dezsoba/Szakdolgozat/Szakdolgozat képek/FixBoardBodge/CIMG1764.JPG

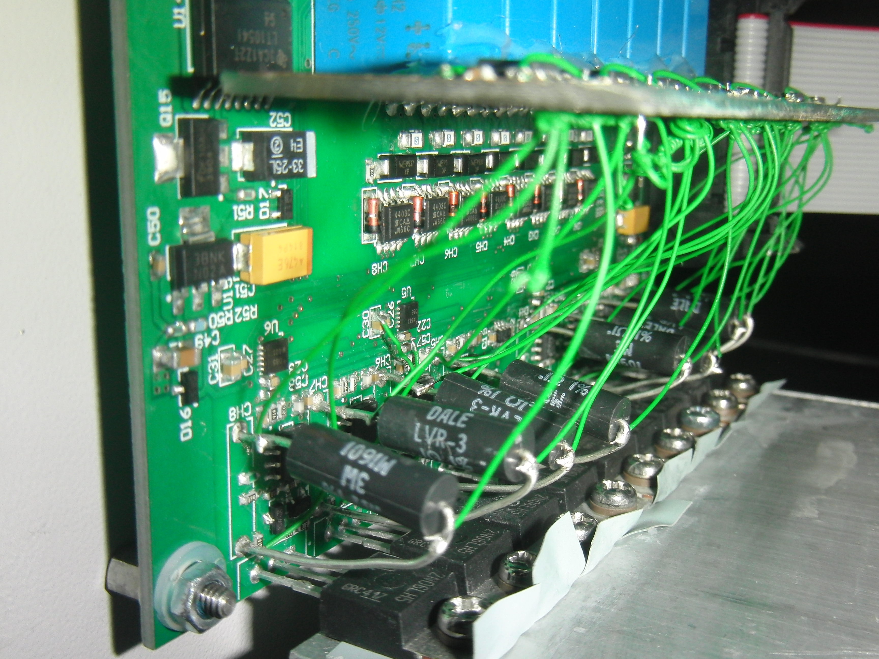
Szakdolgozat képek/FixBoardBodge/CIMG1764.JPG
