dezsoba/Szakdolgozat/Szakdolgozat képek/FixBoardBodge/CIMG1762.JPG

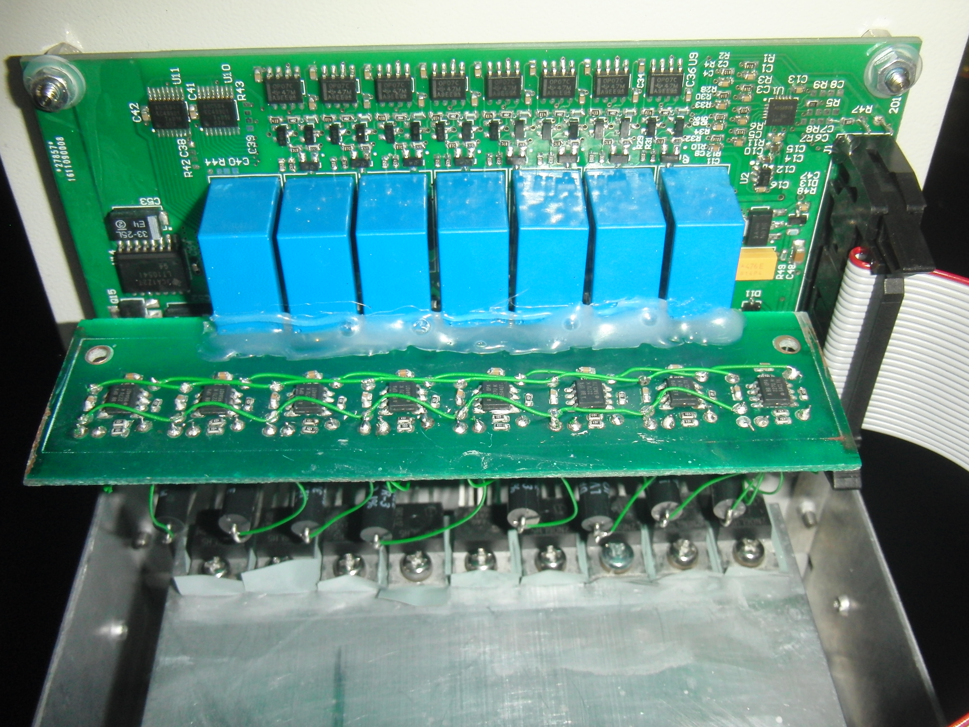
Szakdolgozat képek/FixBoardBodge/CIMG1762.JPG
