dezsoba/Szakdolgozat/Táblázatok/Spec.xlsx

Voltage | Current
15.5 | 0
15.5 | 0.645
15 | 0.666666
14 | 0.71
13 | 0.77
12 | 0.83
11 | 0.91
10 | 1
9 | 1.11
8 | 1.25
7 | 1.43
6 | 1.67
5 | 2
2.22 | 2
1.8 | 0
15.5 | 0
