dezsoba/Szakdolgozat/CopperArea_3V3.png

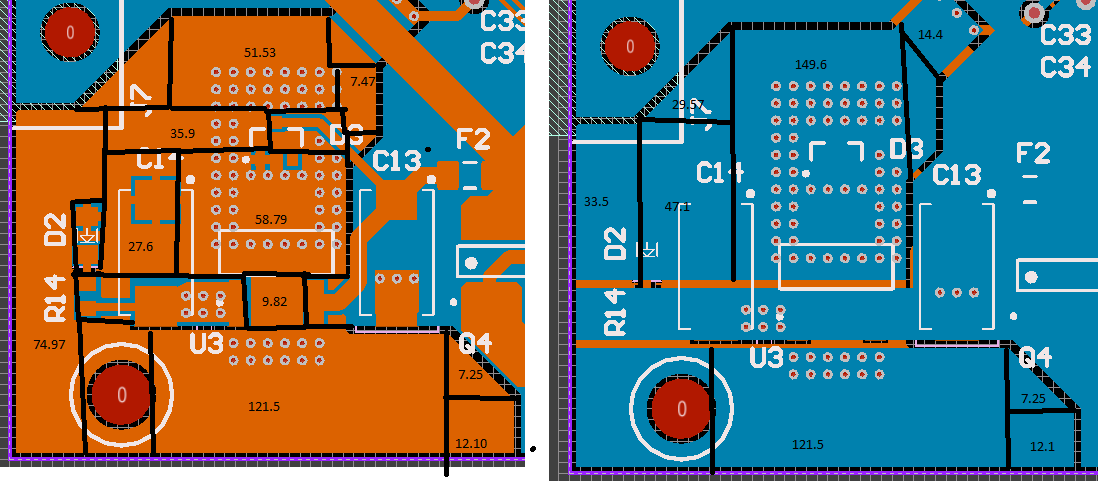
CopperArea_3V3.png
