dezsoba/Szakdolgozat/CopperArea_N7V.png

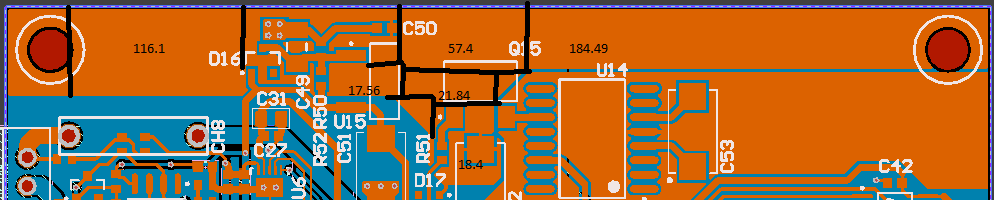
CopperArea_N7V.png
