dezsoba/Szakdolgozat/Szakdolgozat képek/2Opamp.png

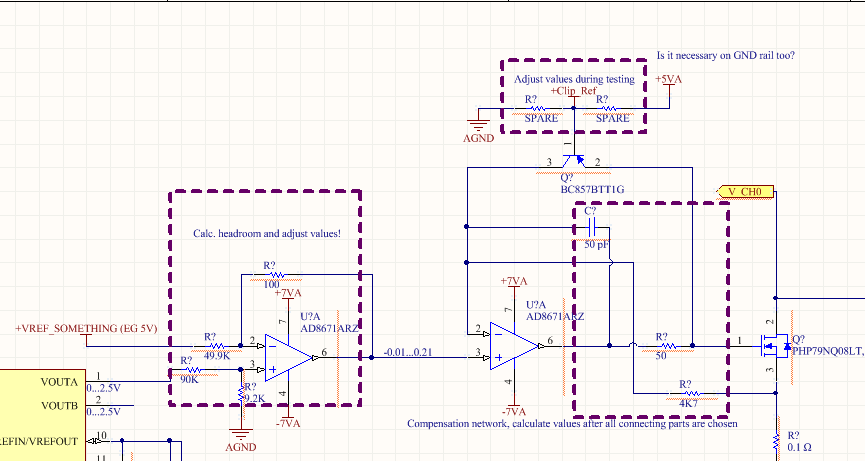
Szakdolgozat képek/2Opamp.png
