dezsoba/Szakdolgozat/Szakdolgozat képek/DFN 1.jpg

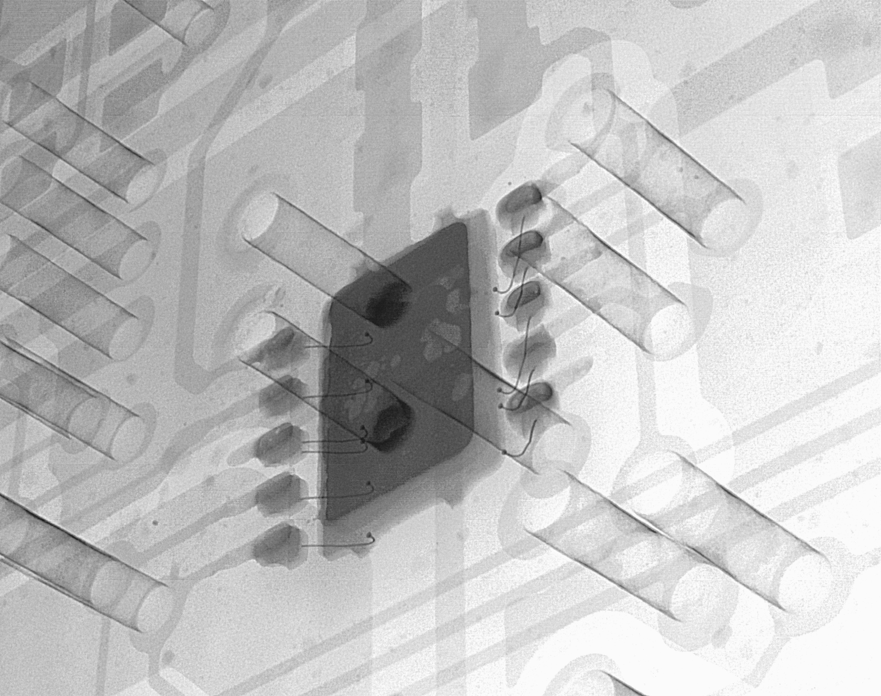
Szakdolgozat képek/DFN 1.jpg
