dezsoba/Szakdolgozat/Szakdolgozat képek/DFN 2.jpg

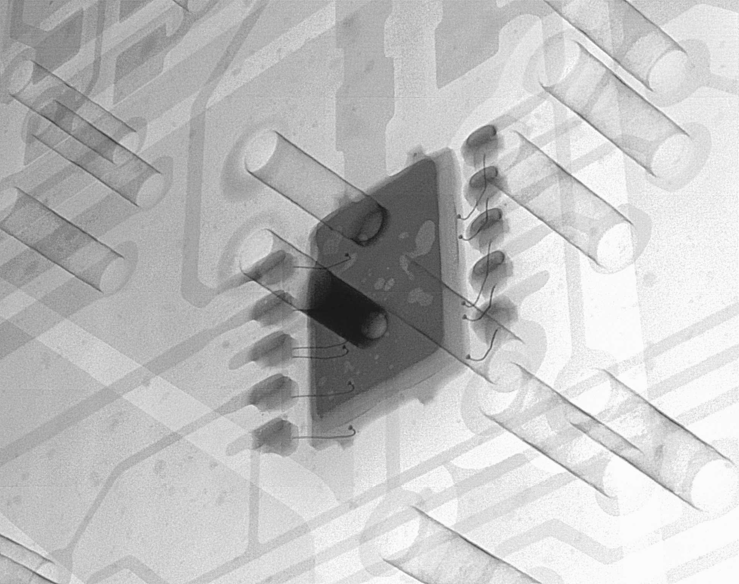
Szakdolgozat képek/DFN 2.jpg
