dezsoba/Szakdolgozat/Szakdolgozat képek/DFN 3.jpg

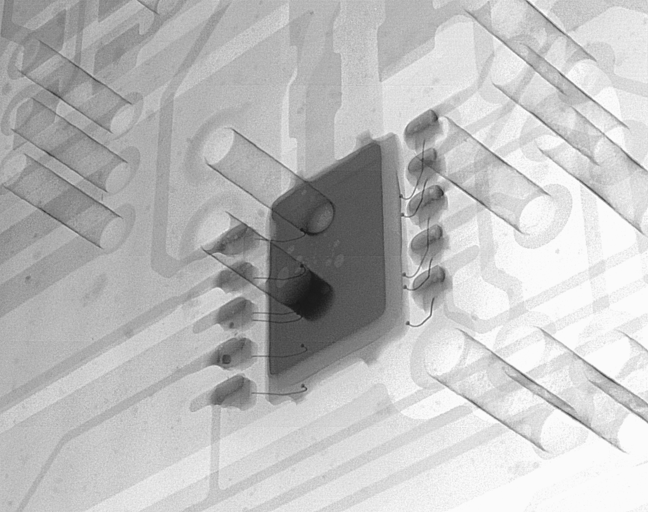
Szakdolgozat képek/DFN 3.jpg
