dezsoba/Szakdolgozat/Szakdolgozat képek/DFN 4.jpg

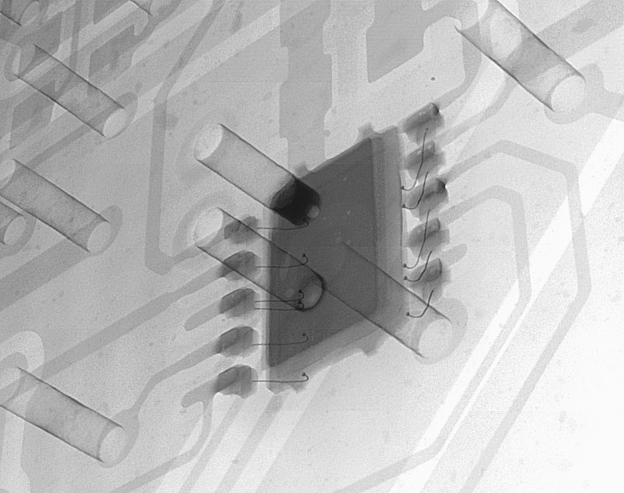
Szakdolgozat képek/DFN 4.jpg
