dezsoba/Szakdolgozat/Szakdolgozat képek/LTSIM.png

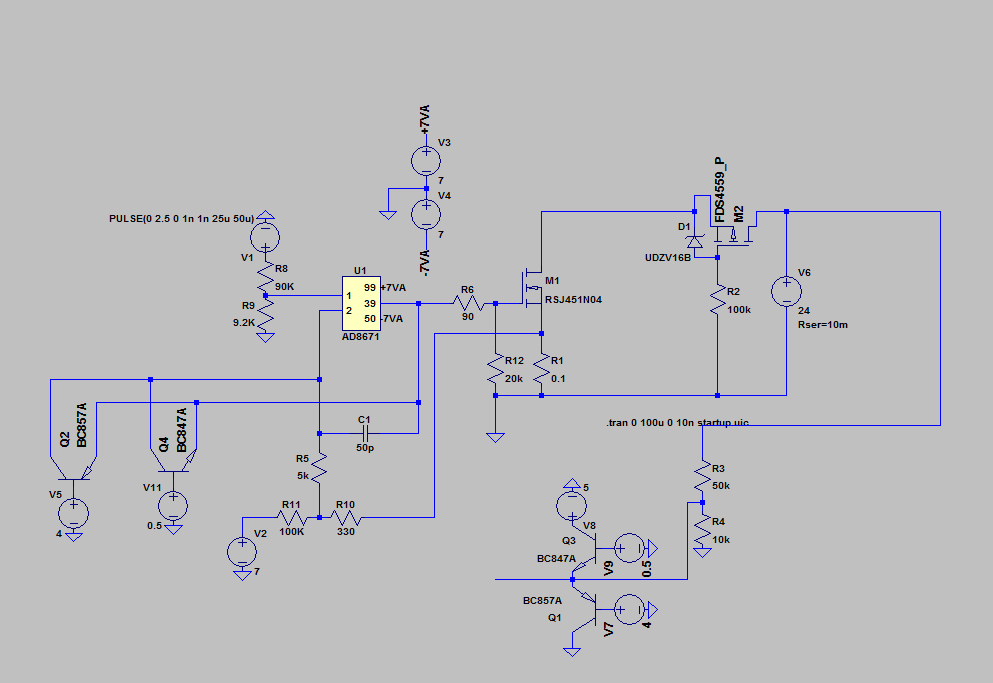
Szakdolgozat képek/LTSIM.png
