dezsoba/Szakdolgozat/Szakdolgozat képek/Mukodes/oszc.PNG

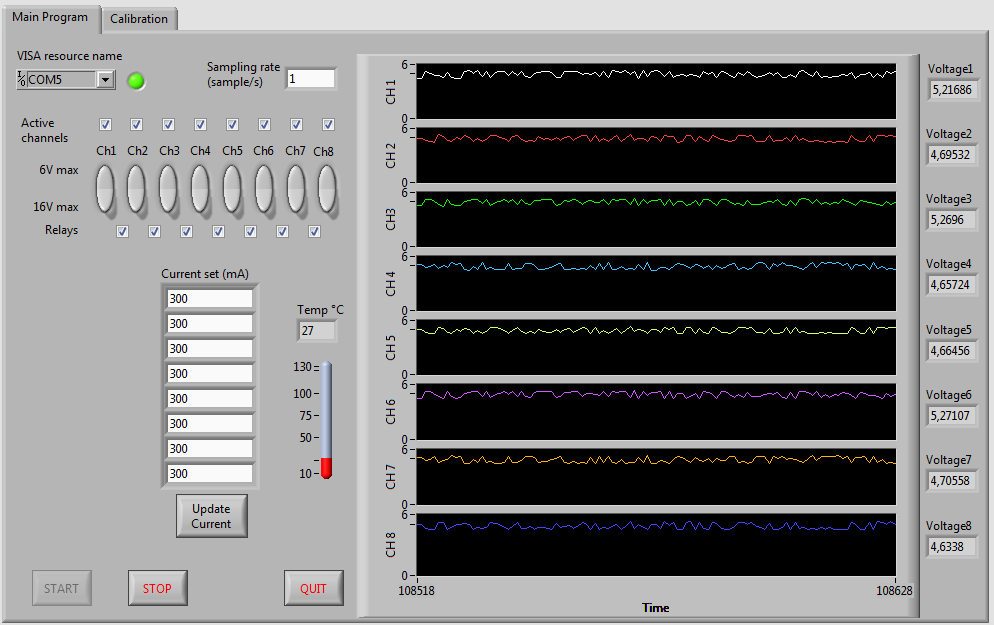
Szakdolgozat képek/Mukodes/oszc.PNG
