dezsoba/Szakdolgozat/Szakdolgozat képek/Mukodes/VB8034-30C8570_2016-11-28_16-03-05.png

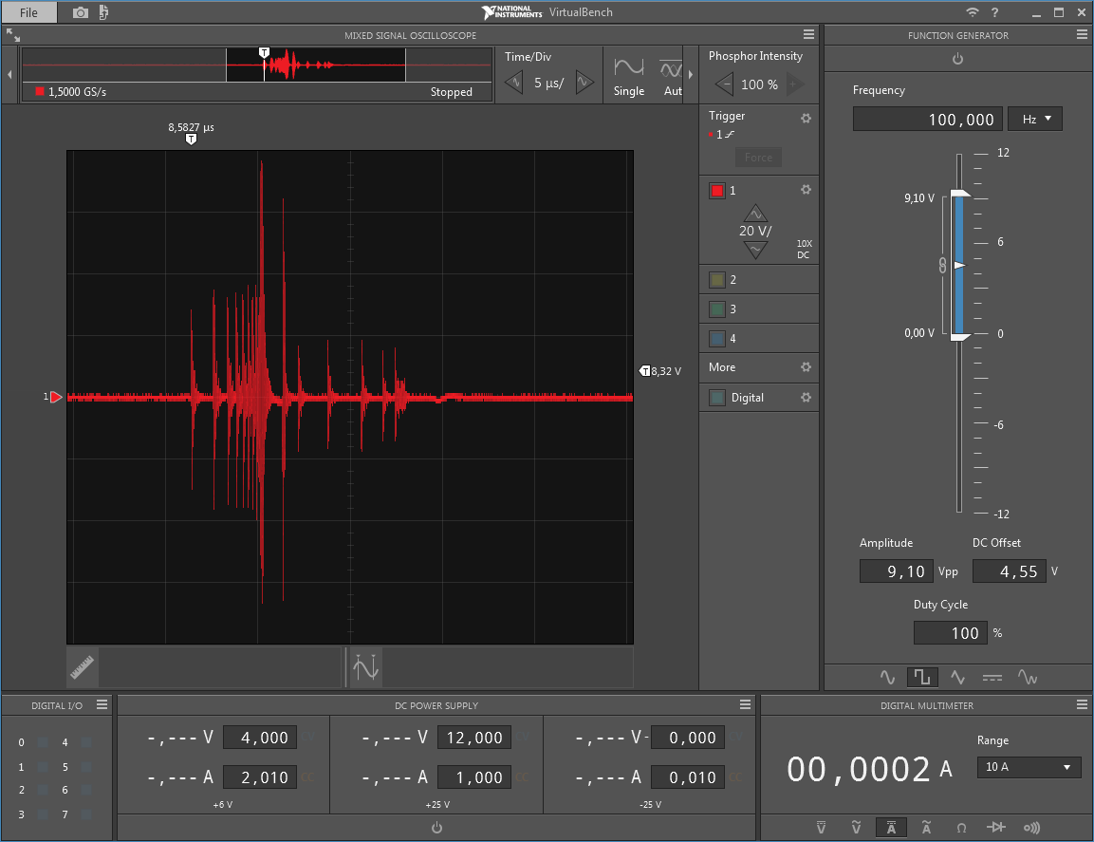
Szakdolgozat képek/Mukodes/VB8034-30C8570_2016-11-28_16-03-05.png
