dezsoba/Szakdolgozat/Szakdolgozat képek/SI/DAC/dac_clk_fall.png

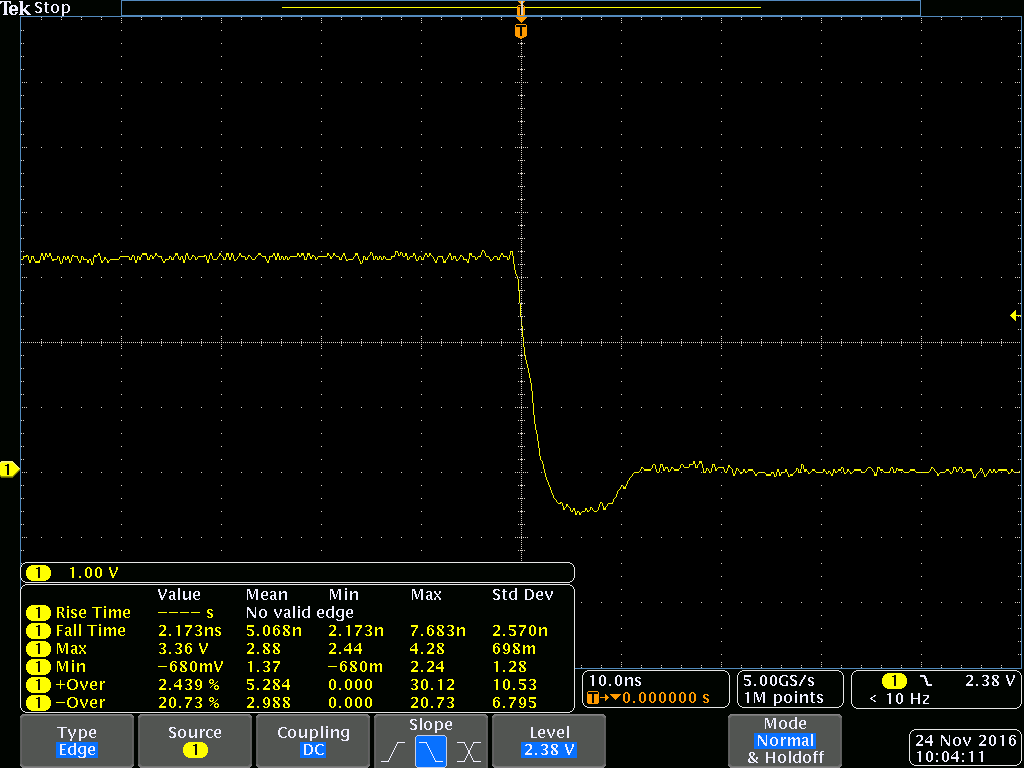
Szakdolgozat képek/SI/DAC/dac_clk_fall.png
