dezsoba/Szakdolgozat/Szakdolgozat képek/SI/DAC/dac_clk_rise.png

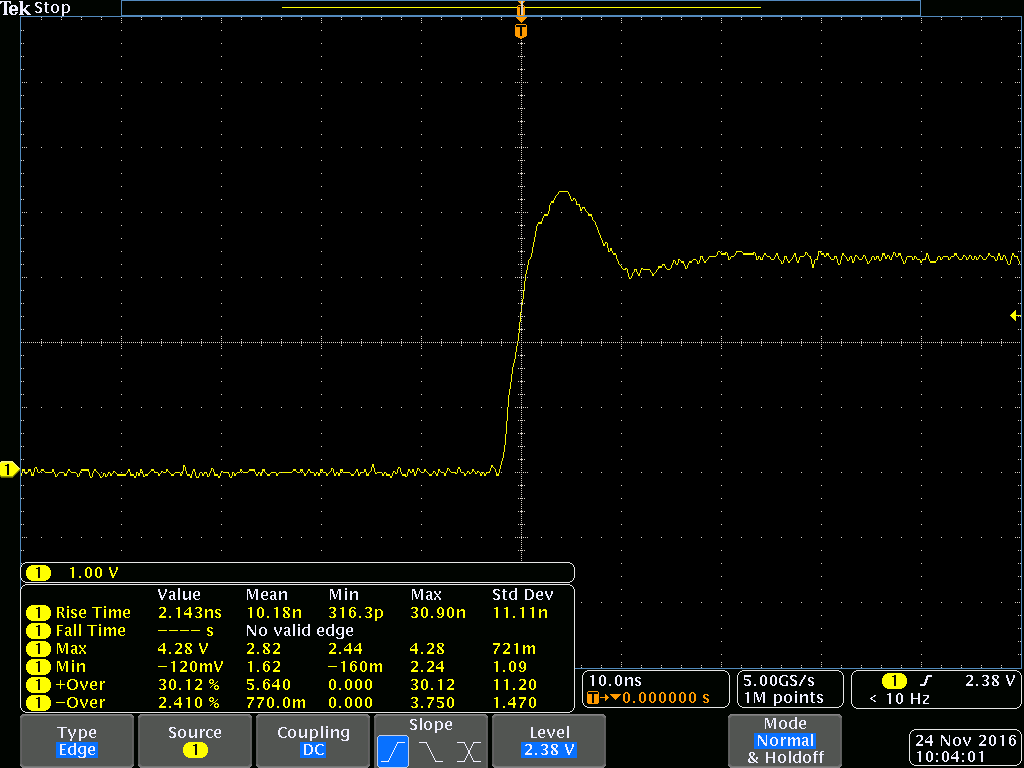
Szakdolgozat képek/SI/DAC/dac_clk_rise.png
