dezsoba/Szakdolgozat/Szakdolgozat képek/SI/DAC/dac_sync_rise.png

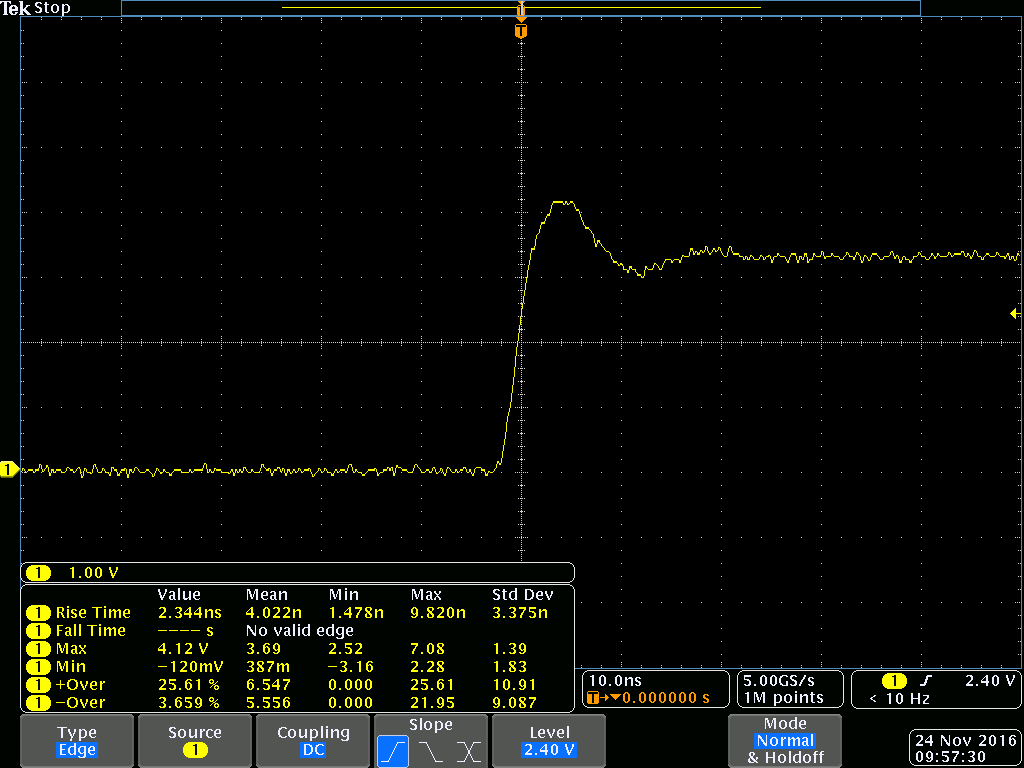
Szakdolgozat képek/SI/DAC/dac_sync_rise.png
