dezsoba/Szakdolgozat/Szakdolgozat képek/SI/I2C/scl_fall1.png

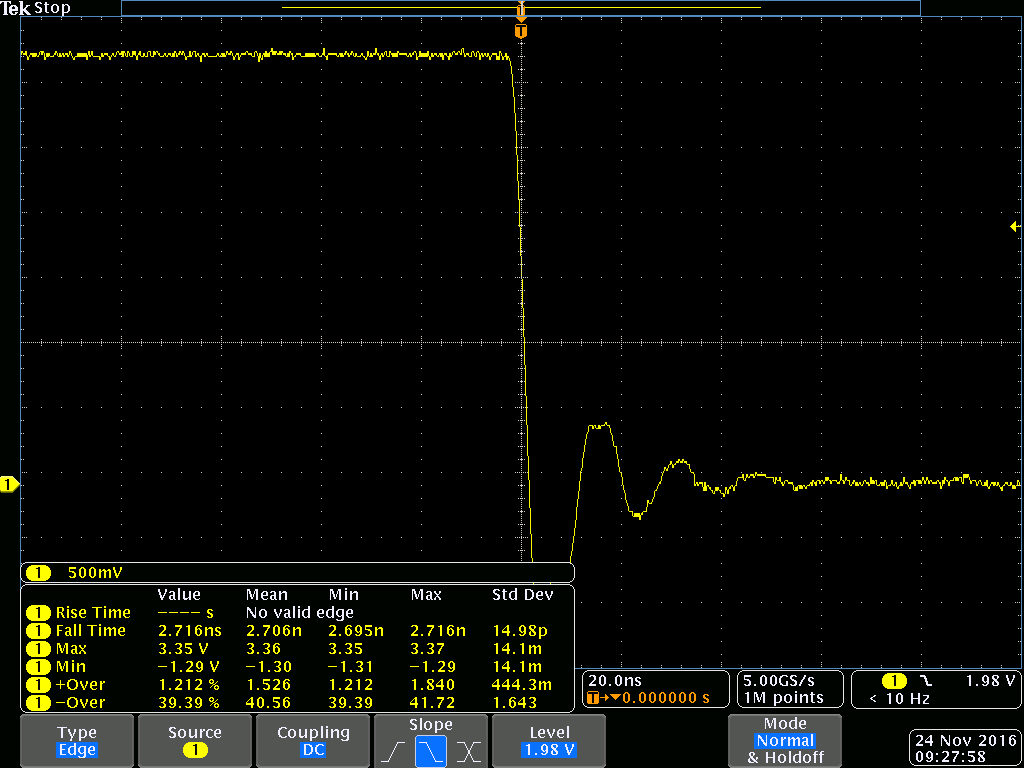
Szakdolgozat képek/SI/I2C/scl_fall1.png
