dezsoba/Szakdolgozat/Szakdolgozat képek/SI/I2C/scl_fall2.png

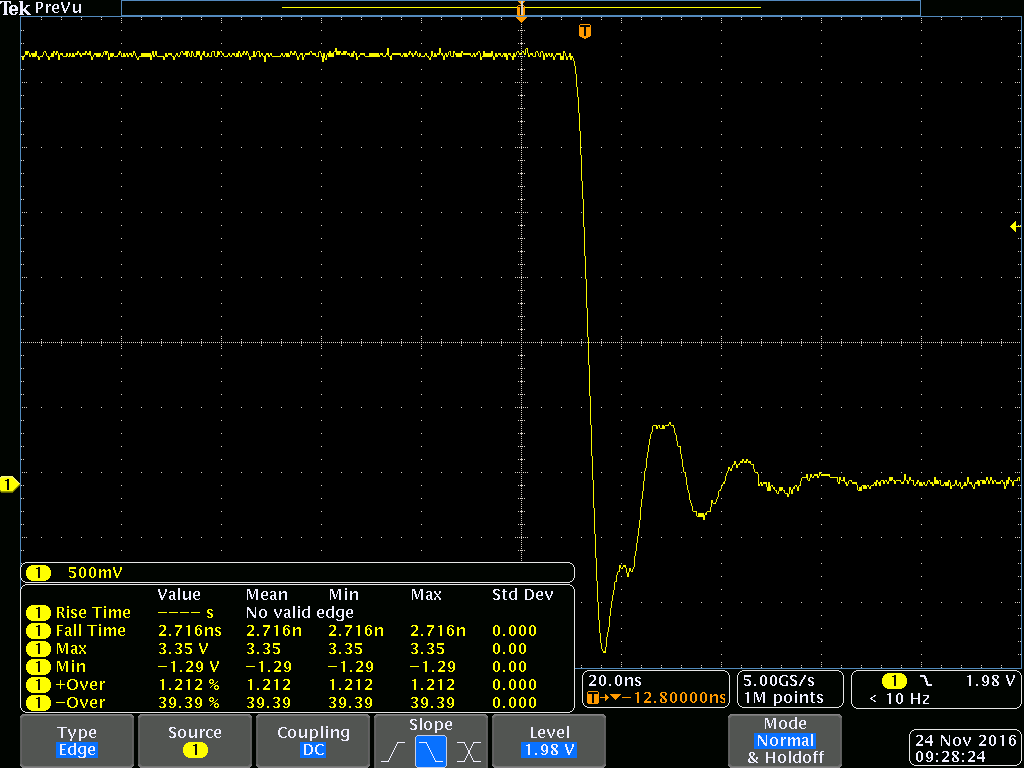
Szakdolgozat képek/SI/I2C/scl_fall2.png
