dezsoba/Szakdolgozat/Szakdolgozat képek/SI/I2C/scl_rise.png

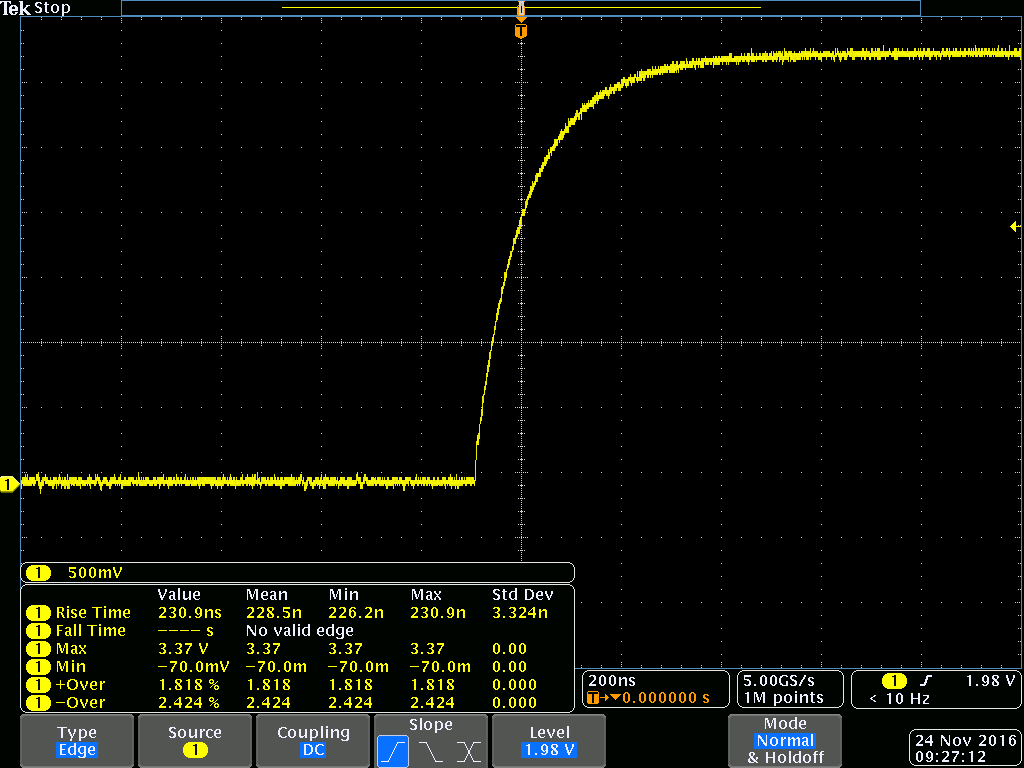
Szakdolgozat képek/SI/I2C/scl_rise.png
