dezsoba/Szakdolgozat/Szakdolgozat képek/Thermal/ActiveLoad/ActiveLoad1.jpg

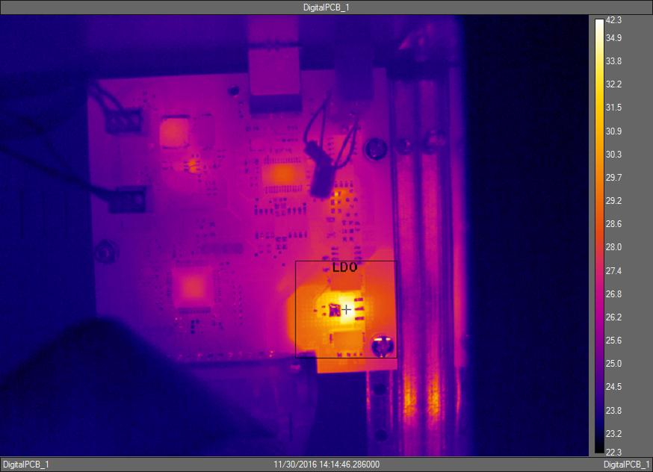
Szakdolgozat képek/Thermal/ActiveLoad/ActiveLoad1.jpg
