dezsoba/Szakdolgozat/Szakdolgozat képek/Thermal/ActiveLoad/ActiveLoad3.jpg

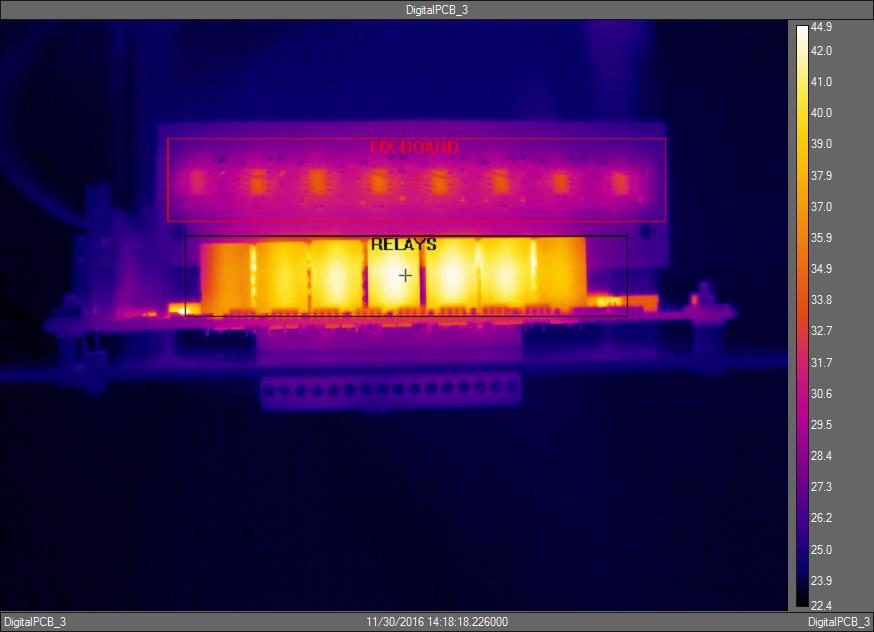
Szakdolgozat képek/Thermal/ActiveLoad/ActiveLoad3.jpg
