dezsoba/Szakdolgozat/Szakdolgozat képek/Thermal/ActiveLoad/ActiveLoad4.jpg

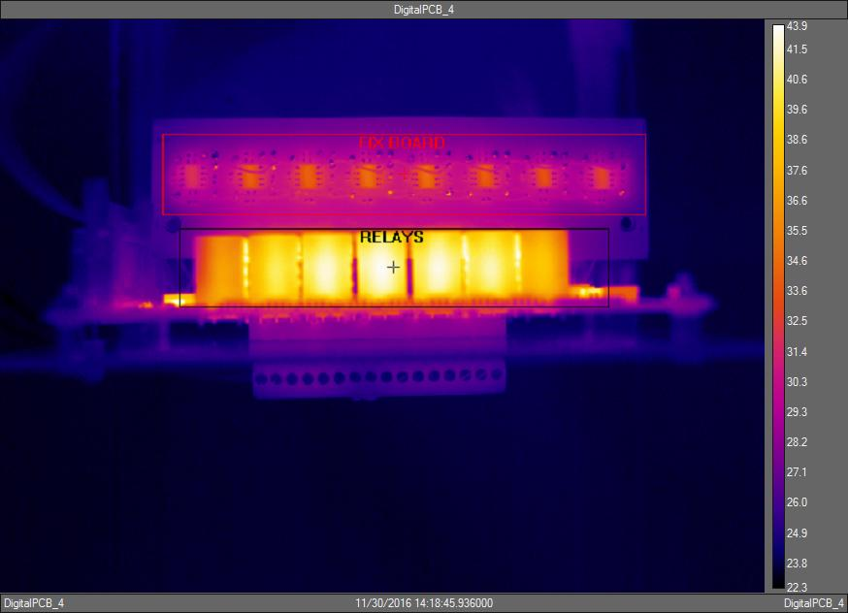
Szakdolgozat képek/Thermal/ActiveLoad/ActiveLoad4.jpg
