dezsoba/Szakdolgozat/Szakdolgozat képek/Thermal/ActiveLoad/ActiveLoad5.jpg

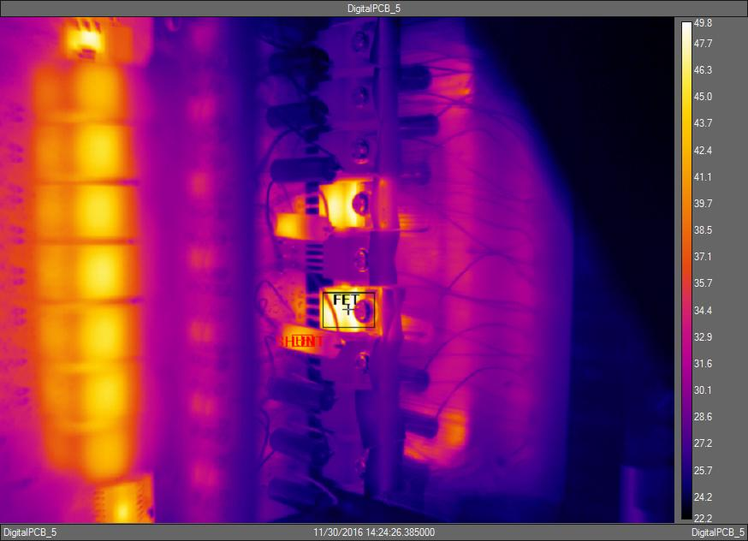
Szakdolgozat képek/Thermal/ActiveLoad/ActiveLoad5.jpg
