dezsoba/Szakdolgozat/Szakdolgozat képek/Thermal/ActiveLoad/ActiveLoad6.jpg

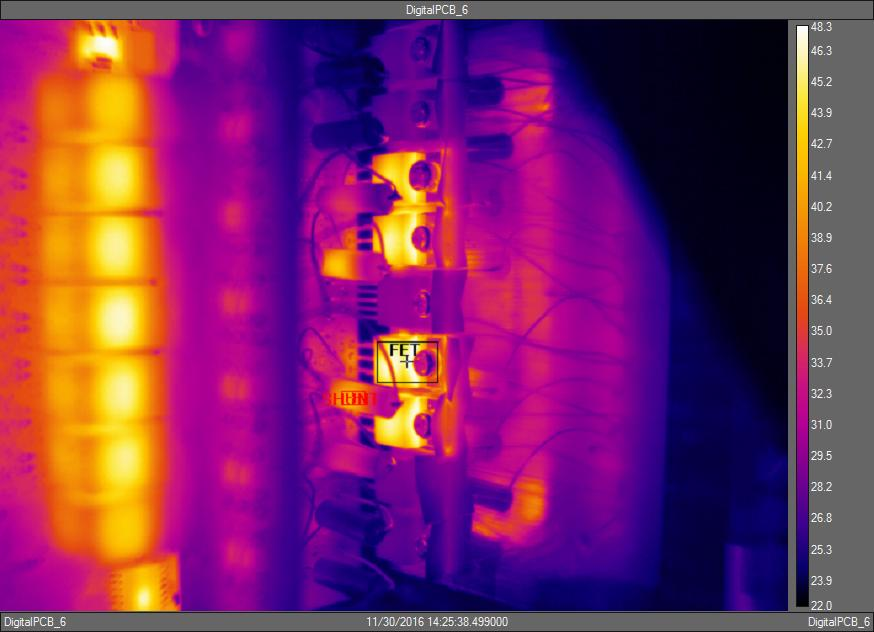
Szakdolgozat képek/Thermal/ActiveLoad/ActiveLoad6.jpg
