dezsoba/Szakdolgozat/Szakdolgozat képek/Thermal/ActiveLoad/ActiveLoad7.jpg

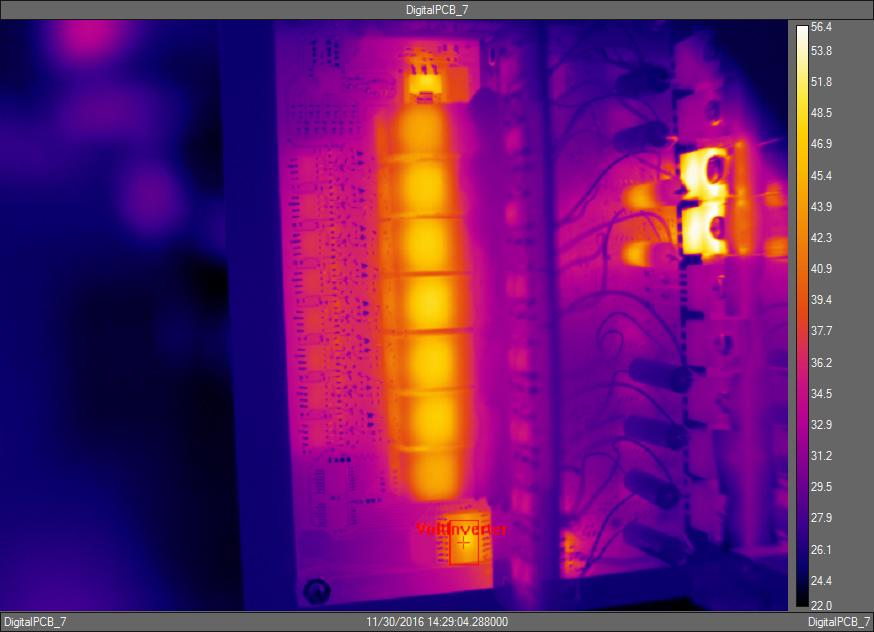
Szakdolgozat képek/Thermal/ActiveLoad/ActiveLoad7.jpg
