dezsoba/Szakdolgozat/Szimulációk/Reverse_Polarity/PMOS/Schematic.PNG

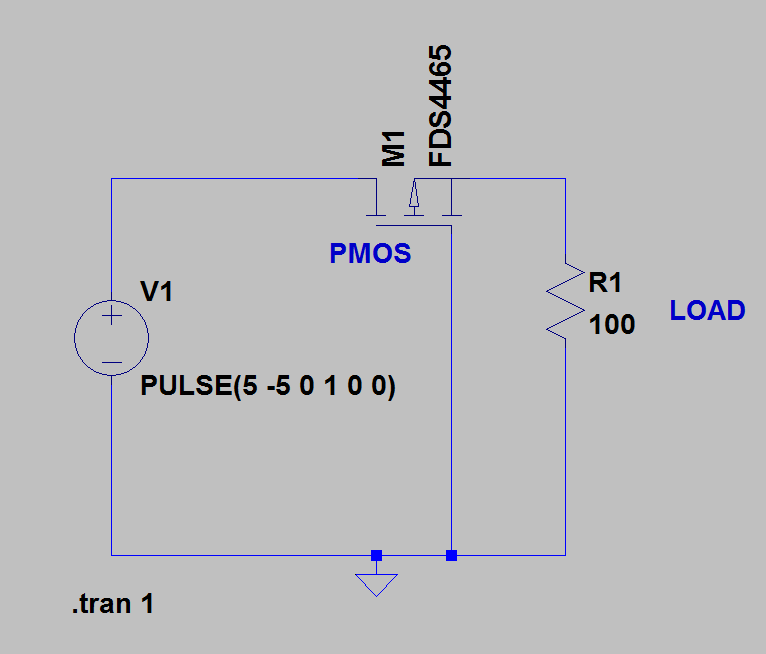
Szimulációk/Reverse_Polarity/PMOS/Schematic.PNG
