dezsoba/Szakdolgozat/Szimulációk/Reverse_Polarity/SCHOTTKY/Schematic.PNG

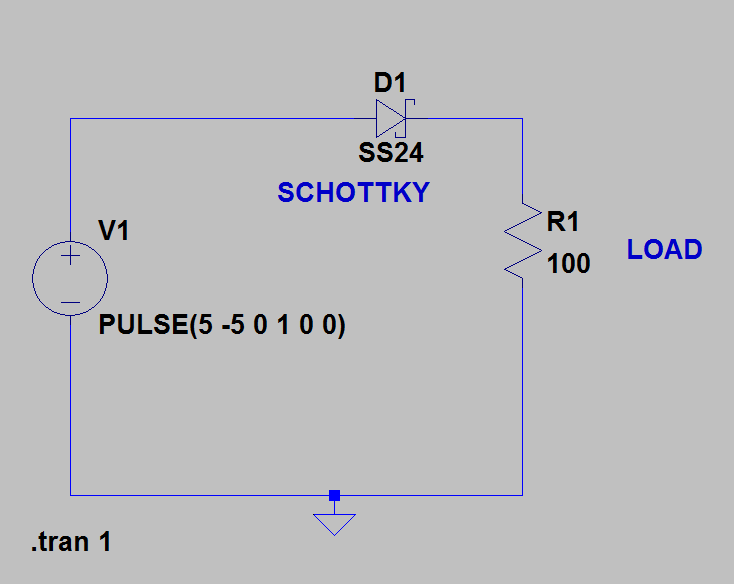
Szimulációk/Reverse_Polarity/SCHOTTKY/Schematic.PNG
