dezsoba/Szakdolgozat/Táblázatok/DigitPCB_BOM/Digital_ORDER.xlsx

 | Ref.Des. | Package | Value | Voltage | Quantity | Source | Echo PN | Farnell PN | Mouser PN
CAP | C2, C3 | 0603 | 15p |  | 2 |  | 715698-01
 | C5, C6, C7, C8, C9, C11, C17, C18, C19, C21, C23, C26, C28, C35, C29, C31, C32, C33, C34 | 0603 | 100n |  | 19 |  | 715679-02
 | C10, C12, C25 | 0603 | 1u |  | 2 |  | 716545-01
 | C27 | 0603 | 4.7u |  | 1 |  | 716657-01
 | C30 | 0603 | 10n |  | 1 |  | 715525-01
 | C4 | 0805 | 4.7u |  | 1 |  | 716057-01
 | C13 | 7343-31 | 10u | 25 | 1 |  | 715382-01
 | C14 | 7343-31 | 47u |  | 1 |  | 715337-01
 | C15, C16, C22 | 7343-31 | 22u |  | 3 |  | 715514-01
RES | R1, R2, R3, R4, R6, R7, R8, R9, R10, R12, R18, R20, R21, R22, R41, R42 | 0603 | 33 |  | 16 |  | 711862-01
 | R11, R14, R45, R47, R50 | 0603 | 1K |  | 5 |  | 711804-01
 | R13, R17, R24, R25, R49, R34, R40 | 0603 | 10K |  | 5 |  | 711803-01
 | R15, R16 | 0603 | 2.2K |  | 2 |  | 611521-01
 | R23, R46, R26, R30, R31, R37, R39, R48 | 0603 | 4.7K |  | 8 |  | 712048-01
 | R27, R38 | 0603 | 1M |  | 2 |  | 711805-01
 | R28, R29 | 0603 | 100K |  | 2 |  | 613154-01
 | R34 | 0603 | 33.2K |  | 1 |  | 711811-01
 | R35 | 0603 | 18.2K |  | 1 |  | 712342-01
 | R36 | 0603 | 2K |  | 1 |  | 613317-01
 | R43, R44 | 0603 | 0 |  | 2 |  | 611560-01
IND | L1 | SM_POW | 22u |  | 1 |  | 713340-01
 | L2 | 0603 | 40Ohm@100MHz |  | 1 |  | 714974-01
DIO | D1, D2, D5, D6, D7, | 0805 | LEDS |  | 5 |  | 735085-01, 735086-01
 | D3 | SOT-23 | BAS21 |  | 1 |  | 730204-01
 | D4 | SOD-80 | 13V Zener |  | 1 |  | - | 1097186 | (min. 5)
TRAN | Q2, Q3, Q4 | SO-8 | FDS4141 |  | 3 |  | - | 2322607
 | Q1, Q5, Q6, Q7, Q8 | SOT-23 | BC847 |  | 5 |  | 733040-01
 | Q9 | SOT-23 | BC857 |  | 1 |  | 733039-01
FUSE | F1 | 1206 | 1.75A |  | 1 |  | - | 2452900
 | F2 | 1206 | 0.125A |  | 1 |  | - | 1596988
IC | U3 | SOT-223 | LM1117MP-3.3 |  | 1 |  | - | 1469051
 | U8 | SOT-23-6 | USBLC6-2SC6 |  | 1 |  | 731032-01
 | U6, U9 | SOIC-8 | ADUM1200B |  | 2 |  | 692897-01
 | U7 | SOP-28 | FT232RL |  | 1 |  | - | 1146032
 | U4 | SOT-23-6 | TPS54202 |  | 1 |  | - | 2576277
 | U5 | SOT-23-5 | AD8515 |  | 1 |  | 697313-01
 | U1 | LQFP-64 | STM32F410 |  | 1 |  | - | 2518136
 | U2 | SOT-23-5 | 24LC16BT |  | 1 |  | - | 9757961
CON | J3 |  | DC BARREL |  | 1 |  | 768861-01
 | J6 |  | USB_FEM_B |  | 1 |  | 768814-01
 | J4, J5 |  | FAN_CON |  | 2 |  | - | 1462950, 1462838
 |  |  | ^SOCKET |  | 6 |  |  | 2063734 | (min. 10)
 | J1 | 2.54mm | HEADER |  | 1 |  | - | 1022263
 | J2 | 2.54mm | HEADER |  | 1 |  | -
XTAL | Y1 | ABM8G | 20 MHz |  | 1 |  | - | 2467844
 | Y2 | ABM8G | 12 MHz |  | 1 |  | - | 2467837
