dezsoba/Szakdolgozat/Táblázatok/Analog_ORDER.xlsx

 | Ref.Des. | Package | Value | Quantity | Echo PN | Farnell PN
CAP | C1, C2, C3, C4, C5, C9, C10, C11 | 0603 | 47 nF | 8 | 715747-01
 | C12, C14, C45, C56, C57, C58 | 0603 | 1 u | 6 | 716545-01
 | C13, C15, C16, C19, C20, C21, C22, C23, C24, C25, C26, C27, C32, C33_CH1, C33_CH2, C33_CH3, C33_CH4, C33_CH5, C33_CH6, C33_CH7, C33_CH8, C34_CH1, C34_CH2, C34_CH3, C34_CH4, C34_CH5, C34_CH6, C34_CH7, C34_CH8, C35_CH1, C35_CH2, C35_CH3, C35_CH4, C35_CH5, C35_CH6, C35_CH7, C35_CH8, C36_CH1, C36_CH2, C36_CH3, C36_CH4, C36_CH5, C36_CH6, C36_CH7, C36_CH8, C41, C42, C44, C47, C50, C54, C55 | 0603 | 100n | 52 | 715679-01
 | C28, C29, C30, C31 | 0805 | 10u | 4 | 716542-01
 | C48, C49 | 1206 | 10u | 2 | 715895-01
 | C43, C46, C51 | 7343-31 | 47u | 3 | 716125-01
 | C37_CH1, C37_CH2, C37_CH3, C37_CH4, C37_CH5, C37_CH6, C37_CH7, C37_CH8 | 0603 | 82p | 8 | 716117-01
 | C52, C53 | 7343-31 | 33u | 2 | 716076-01
RES | R1, R2, R3, R4, R6, R10, R11, R12, R20_CH1, R20_CH2, R20_CH3, R20_CH4, R20_CH5, R20_CH6, R20_CH7, R20_CH8 | 0603 | 100 | 16 | 713003-01
 | R5 | 0603 | 33 | 1 | 711862-01
 | R16_CH1, R16_CH2, R16_CH3, R16_CH4, R16_CH5, R16_CH6, R16_CH7, R16_CH8 | 0603 | 3.20K | 8 | 712882-01 |  | (3.24K)
 | R17_CH1, R17_CH2, R17_CH3, R17_CH4, R17_CH5, R17_CH6, R17_CH7, R17_CH8 | 0603 | 1.43K | 8 | 712881-01
 | R18_CH1, R18_CH2, R18_CH3, R18_CH4, R18_CH5, R18_CH6, R18_CH7, R18_CH8 | 0603 | 5.36K | 8 | 712360-01
 | R19_CH1, R19_CH2, R19_CH3, R19_CH4, R19_CH5, R19_CH6, R19_CH7, R19_CH8 | 0603 | 24.9K | 8 | 613187-01
 | R21_CH1, R21_CH2, R21_CH3, R21_CH4, R21_CH5, R21_CH6, R21_CH7, R21_CH8 | 0603 | 4.99K | 8 | 712398-01
 | R22_CH1, R22_CH2, R22_CH3, R22_CH4, R22_CH5, R22_CH6, R22_CH7, R22_CH8 | 0603 | 93.1K | 8 | 712875-01
 | R23_CH1, R23_CH2, R23_CH3, R23_CH4, R23_CH5, R23_CH6, R23_CH7, R23_CH8 | 0603 | 9.09K | 8 | 712586-01 |  | (1%)
 | R24_CH1, R24_CH2, R24_CH3, R24_CH4, R24_CH5, R24_CH6, R24_CH7, R24_CH8 | 0603 | 866 | 8 | 712920-01
 | R25_CH1, R25_CH2, R25_CH3, R25_CH4, R25_CH5, R25_CH6, R25_CH7, R25_CH8, R34_CH1, R34_CH2, R34_CH3, R34_CH4, R34_CH5, R34_CH6, R34_CH7, R34_CH8 | 0603 | 10K | 16 | 711803-01
 | R26_CH1, R26_CH2, R26_CH3, R26_CH4, R26_CH5, R26_CH6, R26_CH7, R26_CH8 | 0603 | 20K | 8 | 711809-01
 | R27_CH1, R27_CH2, R27_CH3, R27_CH4, R27_CH5, R27_CH6, R27_CH7, R27_CH8 | OAR-1 | 0.1 ? | 8 | 713244-01
 | R28_CH1, R28_CH2, R28_CH3, R28_CH4, R28_CH5, R28_CH6, R28_CH7, R28_CH8 | 0603 | 5.1K | 8 | 613173-01
 | R29_CH1, R29_CH2, R29_CH3, R29_CH4, R29_CH5, R29_CH6, R29_CH7, R29_CH8 | 0603 | 110K | 8 | 713565-01
 | R30_CH1, R30_CH2, R30_CH3, R30_CH4, R30_CH5, R30_CH6, R30_CH7, R30_CH8 | 0603 | 1.91K | 8 | 713157-01
 | R31_CH1, R31_CH2, R31_CH3, R31_CH4, R31_CH5, R31_CH6, R31_CH7, R31_CH8 | 0603 | 27.4K | 8 | 611245-01
 | R32_CH1, R32_CH2, R32_CH3, R32_CH4, R32_CH5, R32_CH6, R32_CH7, R32_CH8 | 0603 | 78.7K | 8 | 712137-01
 | R33_CH1, R33_CH2, R33_CH3, R33_CH4, R33_CH5, R33_CH6, R33_CH7, R33_CH8 | 0603 | 2.74K | 8 | 713355-01
 | R35, R36, R37, R38, R39, R40, R41 | 0603 | 4.7K | 7 | 712048-01
 | R47 | 0603 | 2K | 1 | 712037-01
 | R48, R52 | 0603 | 240 | 2 | 613210-01 |  | (249 ohm) | (6.7+V így)
 | R49, R50, R51 | 0603 | 1.1K | 3 | 613196-01
IC | U2, U7 | SOT23-6 | MAX6071 | 2 | 698425-01
 | U10, U11 | TSSOP16 | 74AHC594 | 2 | 695652-01
 | (U8, U9)CH1…8 | SOIC8 | OP07C | 16 | - | 9589929
 | u14 | SOIC16 | LT1054 | 1 | - | 2323508
 | U12 | SOT223 | LM1117-5 | 1 | 692537-01
 | U13 | SOT223 | LM1117-ADJ | 1 | 693336-01
 | U15 | SOT223 | LM337 | 1 | 691458-01
 | U1 | QFN20 | ADS8028 | 1 | - | 2099884
 | U3, U4, U5, U6 | SON10 | AD5623 | 4 | 697127-01
DIODE | D1 | SOD80 | BAS85 | 1 |  | 1469394
 | D2,CH1…8 | SOD80 | 5.6V zener | 8 | 730549-01
 | D4, D5, D6, D7, D8, D9, D10, D11, D13, D16, D17 | SOT23 | BAS21 | 11 | 730204-01
 | D3,CH1…8 | SMA | SMAJ16CA | 8 | - | 2536507
 | D14 | 5mm LED | LED | 1 | 735000-01
RELAY | K1, K2, K3, K4, K5, K6, K7 | OJ-SS-112LMH,000 | OJ-SS-112LMH,000 | 7 | - | 1891671
FUSE | F1,CH1…8 | 1206 | 4A | 8 | 766292-01
TRAN | Q7,CH1…8 | SOT23 | BSS138 | 8 | 733147-01
 | Q3,CH1…8 | SO8 | SI4403 | 8 | - | 2056683
 | (Q1,Q6)CH1…8 | SOT23 | BC857 | 16 | 733039-01
 | (Q2,Q5)CH1…8, Q8, Q9, Q10, Q11, Q12, Q13, Q14, | SOT23 | BC847 | 23 | 733040-01
 | Q4,CH1…8 | TO220 | IRLB3034 | 8 | - | 1698299
 | Q15 | SOT223 | PZT3904 | 1 | 733200-01
CONN | J2 |  |  | 1 | 765731-01
 |  |  |  | 1 | 765730-01
 | silpad |  |  | 8 |  | 681090
