dezsoba/Szakdolgozat/Táblázatok/RSonline.xlsx

RS PN | Quantity
798-2952 | 10
774-1212 | 1
