dezsoba/Szakdolgozat/Szakdolgozat képek/FINAL TEST/Képkivágás.PNG

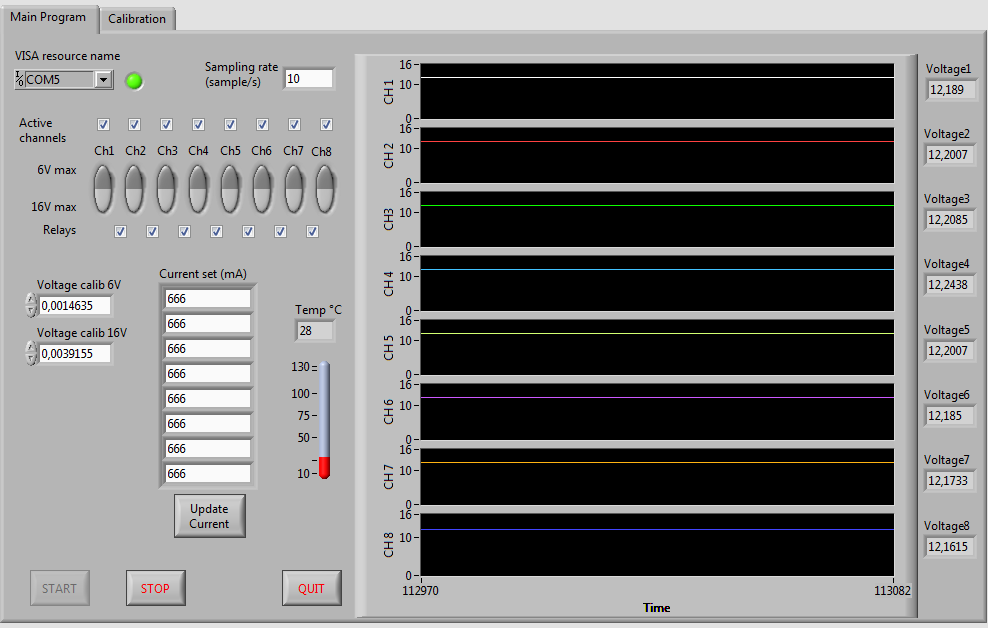
Szakdolgozat képek/FINAL TEST/Képkivágás.PNG
