dezsoba/Szakdolgozat/Szakdolgozat képek/FINAL TEST/VoltageCalibCorrectNumbers.PNG

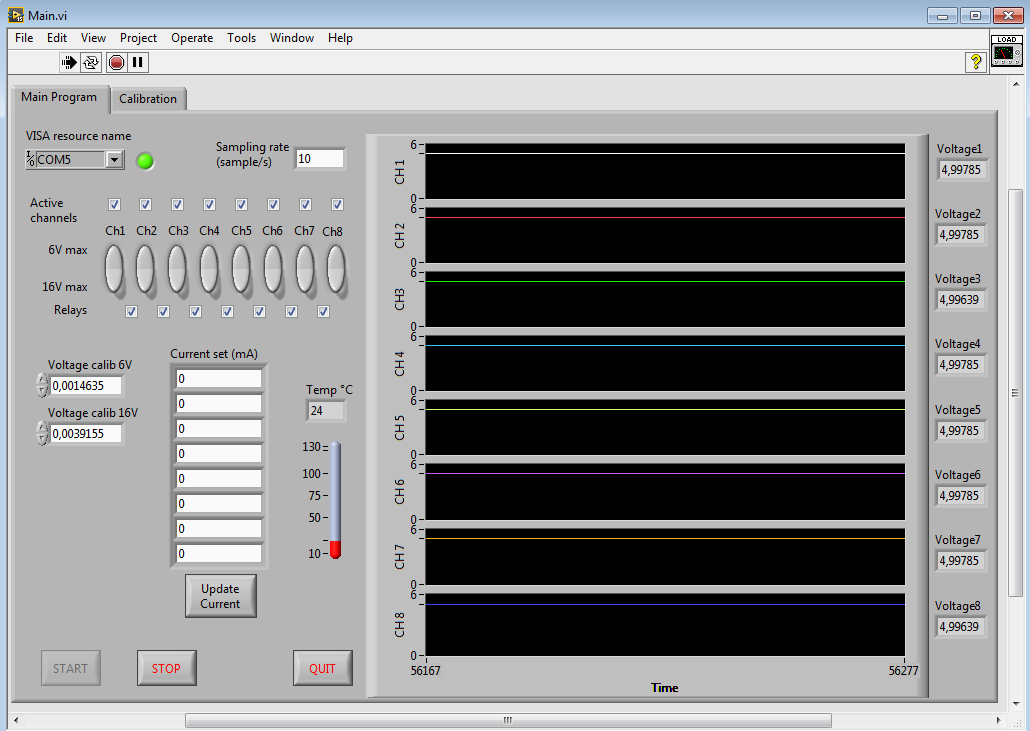
Szakdolgozat képek/FINAL TEST/VoltageCalibCorrectNumbers.PNG
