dezsoba/Szakdolgozat/Szakdolgozat képek/FixBoardBodge/CIMG1759.JPG

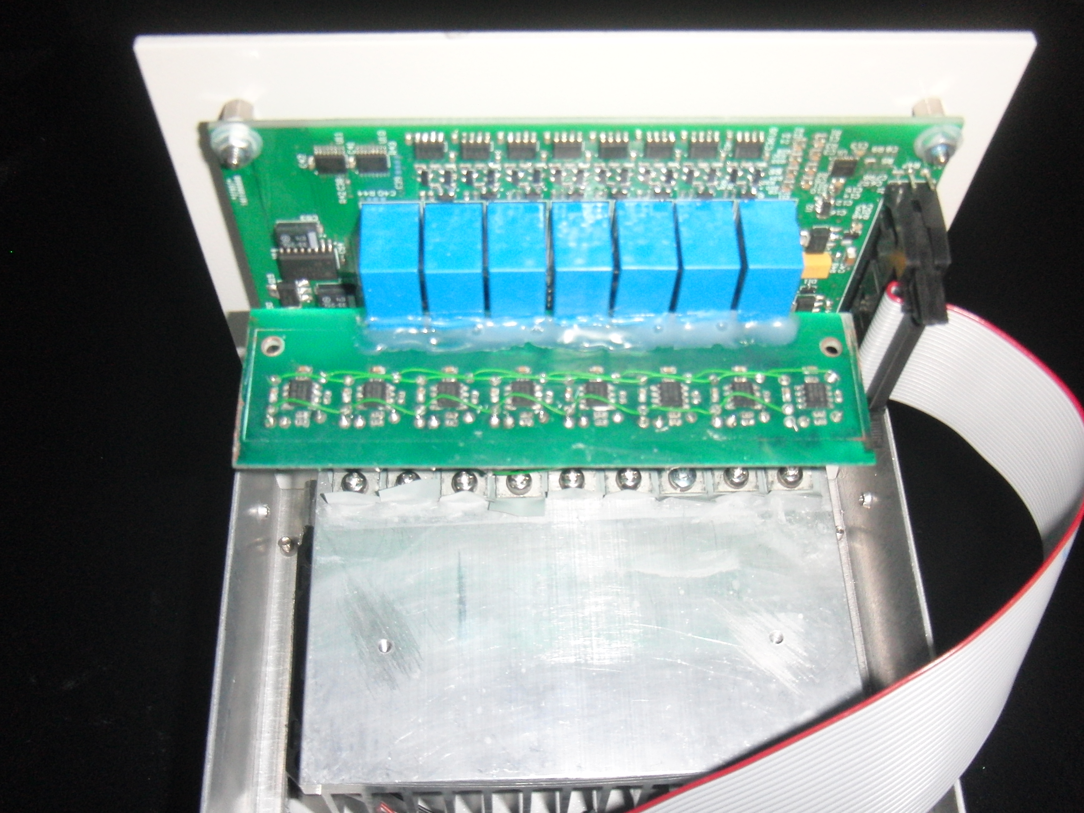
Szakdolgozat képek/FixBoardBodge/CIMG1759.JPG
