dezsoba/Szakdolgozat/Szakdolgozat képek/FixBoardBodge/CIMG1760.JPG

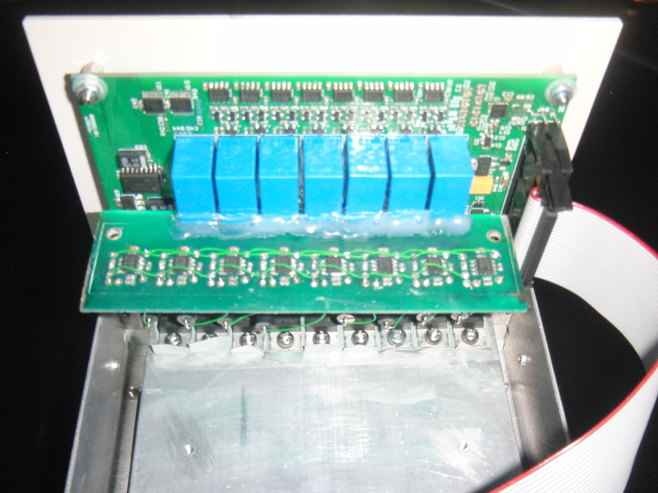
Szakdolgozat képek/FixBoardBodge/CIMG1760.JPG
