dezsoba/Szakdolgozat/Szakdolgozat képek/FixBoardBodge/CIMG1761.JPG

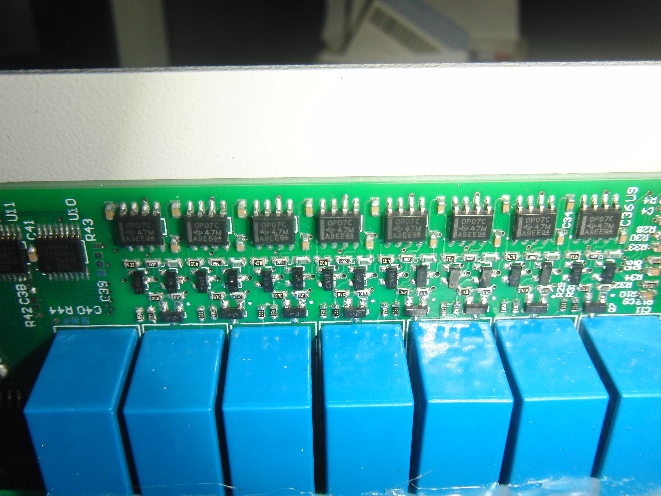
Szakdolgozat képek/FixBoardBodge/CIMG1761.JPG
