dezsoba/Szakdolgozat/Szakdolgozat képek/FixBoardBodge/CIMG1763.JPG

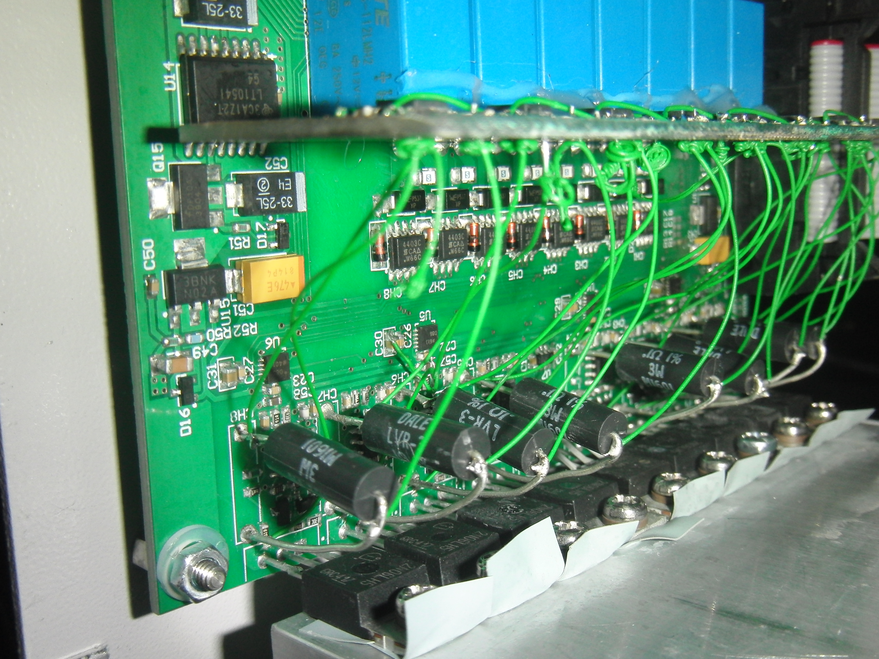
Szakdolgozat képek/FixBoardBodge/CIMG1763.JPG
