dezsoba/Szakdolgozat/Szakdolgozat képek/FixBoardBodge/CIMG1765.JPG

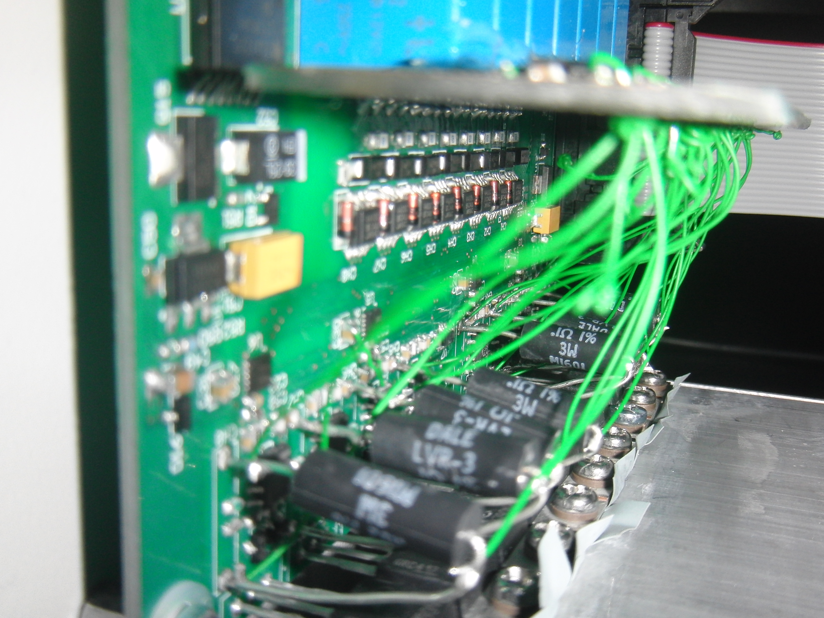
Szakdolgozat képek/FixBoardBodge/CIMG1765.JPG
