dezsoba/Szakdolgozat/Szimulációk/InputClippingLinearity/SIM_WITH_LOAD_0-30range.pdf

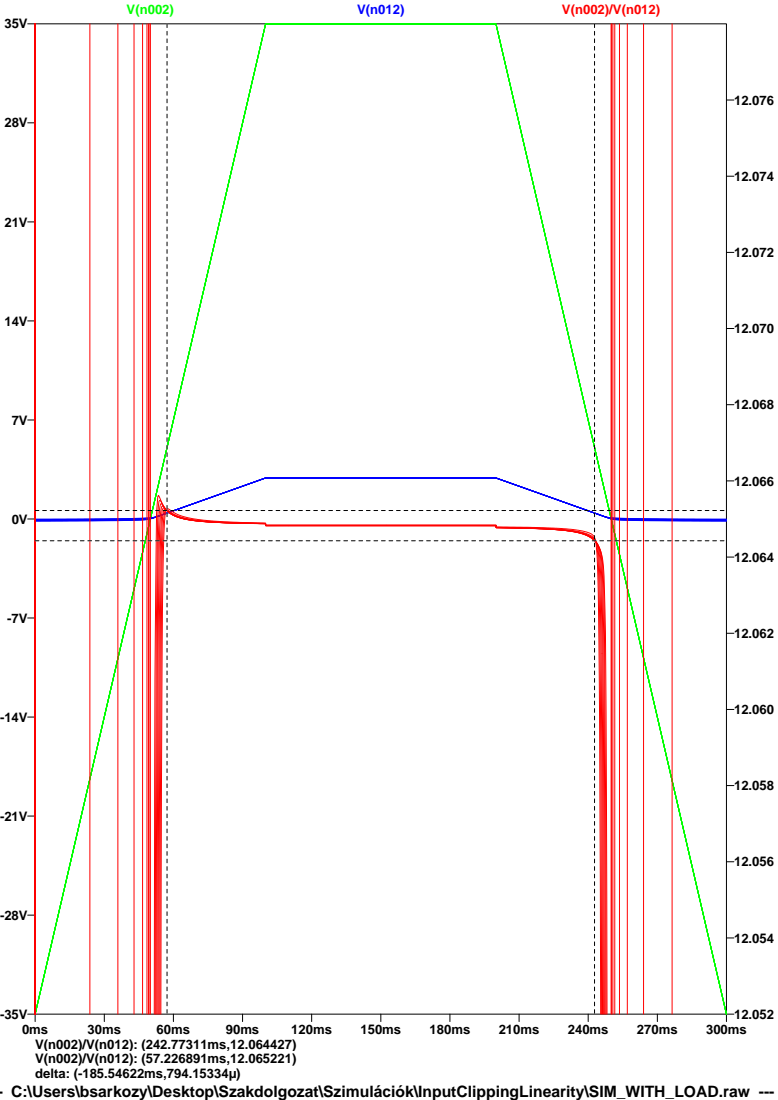
[picture p80: page 1]

delta: (-185.54622ms,794.15334µ)
- C:\Users\bsarkozy\Desktop\Szakdolgozat\Szimulációk\InputClippingLinearity\SIM_WITH_LOAD.raw ---
