dezsoba/Szakdolgozat/Szimulációk/InputClippingLinearity/SIM_WITH_LOAD_0-30range_FINAL.pdf

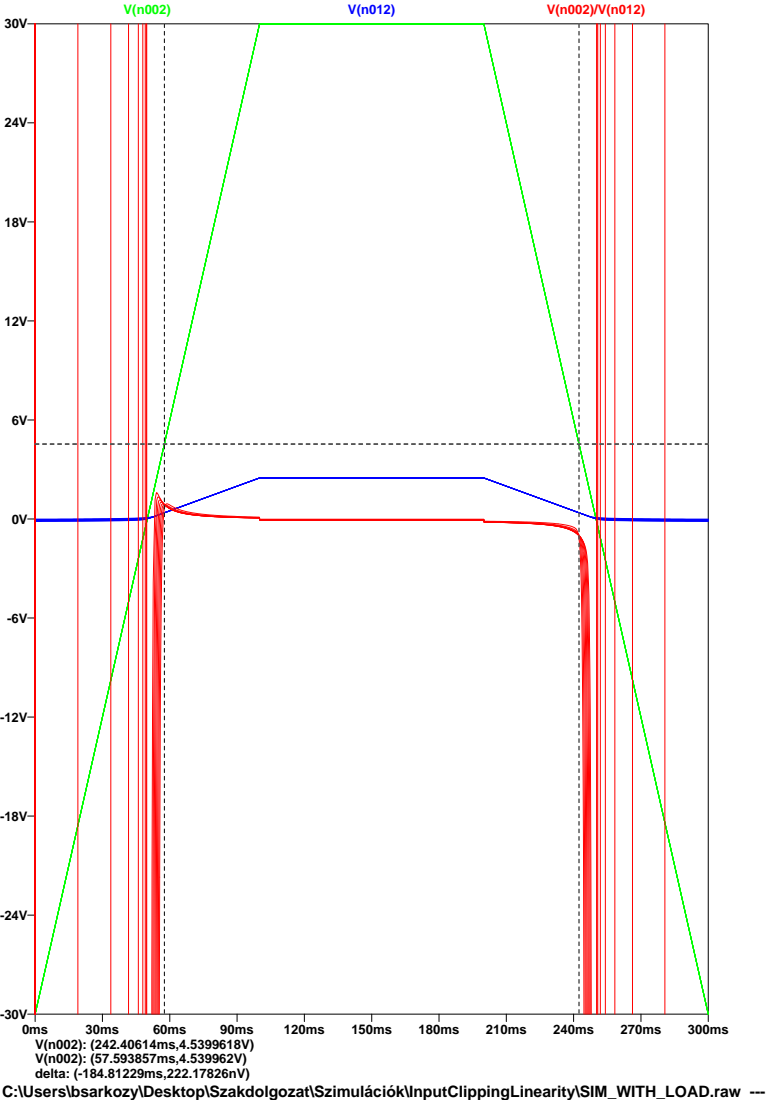
[picture p81: page 1]

delta: (-184.81229ms,222.17826nV)
C:\Users\bsarkozy\Desktop\Szakdolgozat\Szimulációk\InputClippingLinearity\SIM_WITH_LOAD.raw ---
