dezsoba/Szakdolgozat/Szimulációk/InputClippingLinearity/SIM_WITH_LOAD_0-6range.pdf

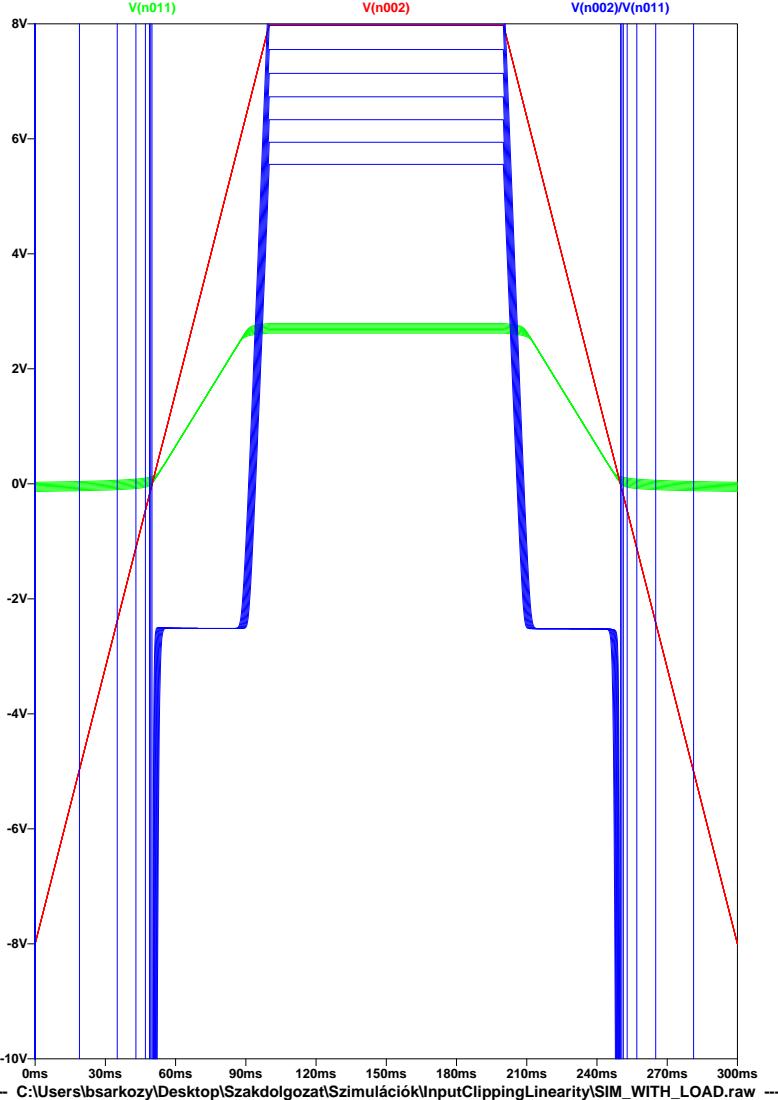
[picture p82: page 1]

-- C:\Users\bsarkozy\Desktop\Szakdolgozat\Szimulációk\InputClippingLinearity\SIM_WITH_LOAD.raw ---
