dezsoba/Szakdolgozat/Szimulációk/InputClippingLinearity/SIM_WITH_LOAD_0-6range_FINAL.pdf

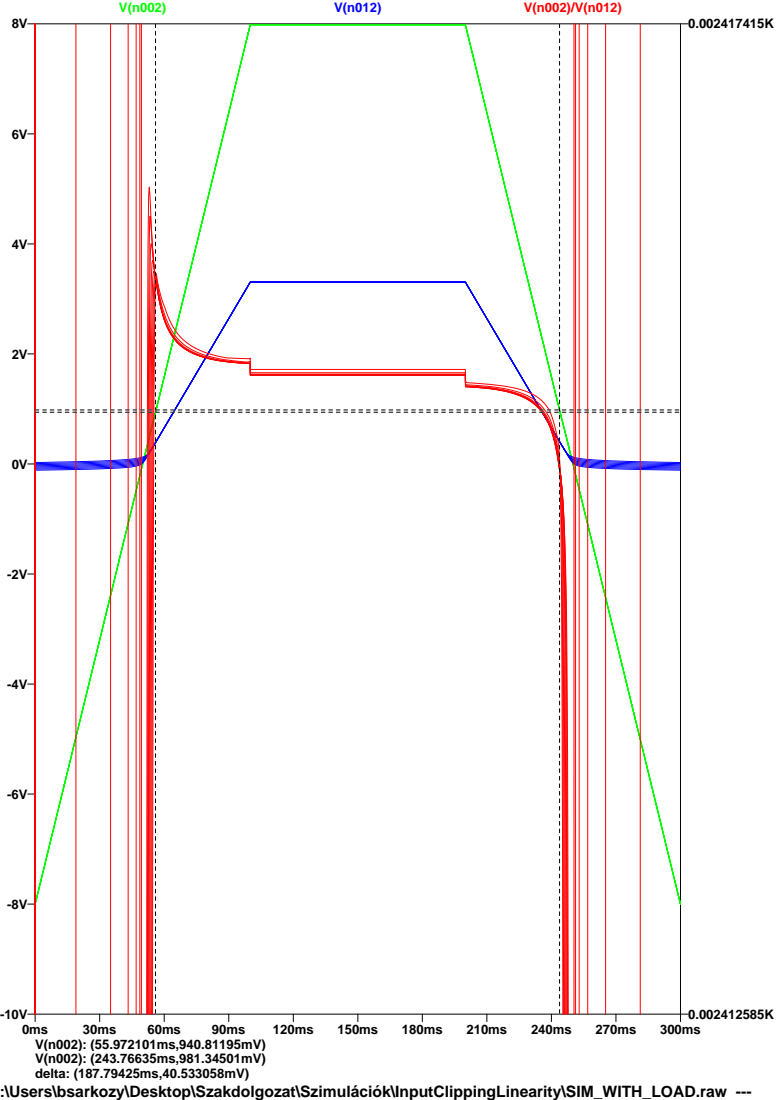
[picture p83: page 1]

delta: (187.79425ms,40.533058mV)
:\Users\bsarkozy\Desktop\Szakdolgozat\Szimulációk\InputClippingLinearity\SIM_WITH_LOAD.raw ---
