dezsoba/Szakdolgozat/Szimulációk/Input_voltage_PMOS/InputVoltage.asc

3.3V_LINE: res; 1.2
C1: cap; 1µ
C2: cap; 70.3µ; Rser=0.5
C3: cap; 382.69µ; Rser=1
D1: zener; EDZV13B
FUSE: res; 0.038
M1: pmos; Si4401DY
M2: pmos; Si4401DY
M3: pmos; Si4401DY
OTHER_LINES: res; 0.001
Q1: npn; BC847A
Q2: npn; BC847A
R1: res; 100K
R2: res; 10K
R3: res; 215
R4: res; 4.7K
R6: res; 10K
R7: res; 1meg
R8: res; 1meg
R10: res; 10
S1: sw; MYSW
V1: voltage; PULSE(20 12 0 0 50m 0 50m)
V2: voltage; 5
Named nets: 0, OVERVPROT, VIN, NEGVPROT
.tran 0 50m 1m startup uic
3.3V capacitance +10%, 55.7mA
Other supply lines capacitance +10%, 1128.3mA
.model MYSW SW(Ron=0.001 Roff=1000meg Vt=2.5 Vh=-.5)
