dezsoba/Szakdolgozat/Szimulációk/InputClippingLinearity/LOAD.asc

C1: cap; 82p
D1: zener; UDZV16B
M1: nmos; RSJ451N04
M2: pmos; FDS4559_P
Q2: pnp; BC857A
Q4: npn; BC847A
R1: res; 0.1
R2: res; 100k
R3: res; 10K
R4: res; 10K
R5: res; 4.99K
R6: res; 93.1
R7: res; 10K
R8: res; 9.09K
R9: res; 866
R10: res; 100
R11: res; 24.9K
R12: res; 20k
R13: res; 10K
U2: OP07
U3: OP07
V1: voltage; PULSE(0 2.5 20m 1n 1n 100m 100m)
V2: voltage; 2.5
V3: voltage; 7
V4: voltage; 7
V5: voltage; 2.5
V6: voltage; 16; Rser=10m
V11: voltage; 0
Named nets: 0, +7VA, -7VA
.tran 0 21m 19m startup uic
Clip @ -0.05V
Clip @ 2.6
