dezsoba/Szakdolgozat/Szimulációk/Dummy_Load_General/Draft1.asc

Rth_c-hs_1: res; ""
Rth_c-hs_2: res; ""
Rth_c-hs_3: res; ""
Rth_c-hs_4: res; ""
Rth_c-hs_5: res; ""
Rth_c-hs_6: res; ""
Rth_c-hs_7: res; ""
Rth_c-hs_8: res; ""
Rth_hs-a_3: res; ""
Rth_j-c_1: res; ""
Rth_j-c_2: res; ""
Rth_j-c_3: res; ""
Rth_j-c_4: res; ""
Rth_j-c_5: res; ""
Rth_j-c_6: res; ""
Rth_j-c_7: res; ""
Rth_j-c_8: res; ""
Named nets: Tj1, Tj2, Tj3, Tj4, Tj5, Tj6, Tj7, Tj8, Ta
