dezsoba/Szakdolgozat/Szimulációk/Thermal/united.asc

Rth_hs-a: res; ""
Rth_j-hs: res; ""
Named nets: Tj, Ta
