dezsoba/Szakdolgozat/Szimulációk/Dummy_Load_General/DummyLoadGeneral.asc

Q1: nmos; IRFH5300
R1: res; {R_SHUNT}
R2: res; {R_SERIES}
U1: OP07
V1: voltage; 7
V2: voltage; 7
V3: voltage; {V_CONTROL}
V4: voltage; {V_SUPPLY}
Named nets: 0, +V, -V, V_OUT
