dezsoba/Szakdolgozat/Szimulációk/ADCInput/ADCInputSYM_withAMP2.asc

C1: cap; 40p
C2: cap; 8p
C3: cap; 47n
R1: res; 130
R2: res; 100
R3: res; 78.7K
R4: res; 110K
S1: sw; MYSW
U1: OP07
V1: voltage; PULSE(0 5 1m 1p 1p 100n 100u)
V2: voltage; PULSE(1.8 6 0 1p 1p 2m 4m)
V3: voltage; 7
V4: voltage; 7
Named nets: 0, InputCap, Switch, SampleCap, +7VA, -7VA, In
.tran 0 8m 1m uic
.model MYSW SW(Ron=1 Roff=1000Meg Vt=.5 Vh=-.4)
.ic V(InputCap)=6
