dezsoba/Szakdolgozat/Szimulációk/InputClippingLinearity/ONLY_CLIPPING.asc

Q1: pnp; BC857C
Q3: npn; BC847C
R1: res; 27.4K
R3: res; 110K
R4: res; 78.7K
R13: res; 1.91K
R14: res; 5.36k
R15: res; 2.74K
V3: voltage; 7
V4: voltage; 7
V6: voltage; PULSE(-10 20 0 100m 100m 100m 350m); Rser=10m
Named nets: 0, +7VA, -7VA, IN, IN_PROT
.tran 0 300m 0 1u startup uic
.step temp 10 80 10
