dezsoba/Szakdolgozat/Szimulációk/InputClippingLinearity/SIM_WITH_LOAD.asc

C1: cap; 82p
D1: zener; UDZV16B
M1: nmos; RSJ451N04
M2: pmos; FDS4559_P
Q1: pnp; BC857A
Q2: pnp; BC857A
Q3: npn; BC847A
Q4: npn; BC847A
Q5: pnp; BC857A
Q6: npn; BC847A
R1: res; 0.1
R2: res; 100k
R3: res; 110K
R4: res; 77.7K
R5: res; 4.99K
R6: res; 93.1
R7: res; 11.4K
R8: res; 9.09K
R9: res; 866
R10: res; 100
R11: res; 24.9K
R12: res; 20k
R13: res; 1.91K
R14: res; 5.36k
R15: res; 2.74K
R16: res; 2k
R17: res; 2k
U2: OP07
V1: voltage; PULSE(0 2.5 20m 1n 1n 100m 100m)
V2: voltage; 2.5
V3: voltage; 7
V4: voltage; 7
V5: voltage; 2.5
V6: voltage; 16; Rser=10m
V7: voltage; 7
V8: voltage; 7
V9: voltage; 7
V10: voltage; 7
V11: voltage; 0
Named nets: 0, +7VA, -7VA
.tran 0 21m 19m startup uic
Clip @ -0.05V
Clip @ 2.6
