dezsoba/Szakdolgozat/Szimulációk/ADCInput/ADCInputSYM_withAMP.asc

C1: cap; 40p
C2: cap; 8p
C3: cap; 47n
R1: res; 130
R2: res; 100
R3: res; 10K
R4: res; 40K
S1: sw; MYSW
U2: AD8671
V1: voltage; PULSE(0 1 100.01u 1p 1p 100n 0 1)
V2: voltage; 30
V3: voltage; 7
V4: voltage; 7
Named nets: 0, InputCap, Vinp
.tran 0 100.2u 100u uic
.model MYSW SW(Ron=1 Roff=1Meg Vt=.5 Vh=-.4)
.ic V(InputCap)=6
Max CLK: 20MHz
Acquisition time: 100ns minimum
.ic V(Vinp)=6
