dezsoba/Szakdolgozat/Szimulációk/ADCInput/ADCInputSYM_withoutAMP.asc

C1: cap; 40p
C2: cap; 8p
C3: cap; 47n
R1: res; 130
R2: res; 100
R3: res; 1K
R4: res; 4K
S1: sw; MYSW
V1: voltage; PULSE(0 1 10n 1p 1p 100n 0 1)
V2: voltage; 30
Named nets: 0, InputCap
.tran 200n uic
.model MYSW SW(Ron=1 Roff=1Meg Vt=.5 Vh=-.4)
.ic V(InputCap)=6
Max CLK: 20MHz
Acquisition time: 100ns minimum
