dezsoba/Szakdolgozat/Szimulációk/FAN_DCDC/DCDC_conv.asc

C2: cap; 47µ; Rser=0.5
C3: cap; 47µ; Rser=0.5
C5: cap; 470n; Rser=0.5
D1: schottky; ZLLS2000
L1: ind; 47µ
M1: pmos; FDS4435A
R1: res; 110K
R2: res; 33K
R3: res; 100
R4: res; 8.2K
R6: res; 36
R7: res; 4.87K
R8: res; 18.2K
U1: LM25085_TRANS
V1: voltage; 12
V2: voltage; 0
Named nets: 0, +12V
.tran 0 100m 0 startup uic
