dezsoba/Szakdolgozat/Szimulációk/InrushLimit/InrushLimit.asc

C1: cap; 1µ
C2: cap; 470µ; Rser=0
M1: pmos; Si7113DN
R1: res; 1meg
R2: res; 100K
R3: res; 6
V1: voltage; 12
Named nets: 0
.tran 500m startup uic
