dezsoba/Szakdolgozat/Szimulációk/OverVoltProt/OverVoltProt.asc

D1: zener; TDZ15B
R1: res; 470
R2: res; 0.1
U1: S4006RS2
V1: voltage; PULSE(0 20 0 100m 1m 1m 102m)
Named nets: 0
.tran 250m startup uic
