dezsoba/Szakdolgozat/Szimulációk/PWM-DC_Conv/PWMtoDC.asc

C1: cap; 1µ
R1: res; 1meg
T1: tline; Td=56p Z0=120
U2: AD8515
V1: voltage
V2: voltage; 3.3
Named nets: 0, +3.3V, OUT, IN, PWM_OUT
