dezsoba/Szakdolgozat/Szimulációk/VoltageInverter/LT1054.asc

C1: cap; 10µ
C2: cap; 100µ
R1: res; 240
U1: LT1054
V1: voltage; 12
Named nets: 0
.tran 150m startup uic
