dezsoba/Szakdolgozat/Szimulációk/Reverse_Polarity/PMOS/SIM.asc

M1: pmos; FDS4465
R1: res; 100
V1: voltage; PULSE(5 -5 0 1 0 0)
Named nets: 0
.tran 1
LOAD
PMOS
