dezsoba/Szakdolgozat/Szimulációk/Reverse_Polarity/PMOS/SIM_WITH_LOAD.asc

C1: cap; 50p
D1: zener; UDZV16B
M1: nmos; RSJ451N04
M2: pmos; FDS4559_P
Q1: pnp; BC857A
Q2: pnp; BC857A
Q3: npn; BC847A
Q4: npn; BC847A
R1: res; 0.1
R2: res; 100k
R3: res; 110K
R4: res; 77.7K
R5: res; 5k
R6: res; 90
R8: res; 90K
R9: res; 9.2K
R10: res; 330
R11: res; 100K
R12: res; 20k
R13: res; 1.07k
R14: res; 5.36k
R15: res; 3.57k
U1: AD8671
V1: voltage; 2
V2: voltage; 7
V3: voltage; 7
V4: voltage; 7
V5: voltage; 2.5
V6: voltage; PULSE(-8 8 0 100m 100m 100m 350m); Rser=10m
V7: voltage; 7
V8: voltage; 7
V9: voltage; 7
V10: voltage; 7
V11: voltage; 0
Named nets: 0, +7VA, -7VA
.tran 300m startup uic
Clip @ -0.05V
Clip @ 2.6
