dezsoba/Szakdolgozat/Szimulációk/Reverse_Polarity/PMOS/SIM_WITH_LOAD_NO_ADC_INP.asc

C1: cap; 68p
D1: zener; UDZV16B
M1: nmos; RSJ451N04
M2: pmos; FDS4559_P
Q2: pnp; BC857A
Q4: npn; BC847A
R1: res; 0.1
R2: res; 100k
R3: res; 1.43K
R4: res; 3.2K
R5: res; 4.99K
R6: res; 89.8
R7: res; 5.36K
R8: res; 9.09K
R9: res; 876
R10: res; 100
R11: res; 24.9K
R12: res; 20k
U1: AD8671
V1: voltage; PULSE(0 2.5 0 1p 1p 1m 2m)
V2: voltage; 2.5
V3: voltage; 7
V4: voltage; 7
V6: voltage; 20; Rser=0
Named nets: 0, +7VA, -7VA
.tran 0 3m 0 10n startup uic
