dezsoba/Szakdolgozat/Szimulációk/Reverse_Polarity/SCHOTTKY/Draft1.asc

M1: nmos; RSJ451N04
M2: pmos; FDS4685
R1: res; 0.1
U1: OP07
V1: voltage; PULSE(30 -30 0 1 1 0 2)
V2: voltage; 0.2
V3: voltage; 12
V4: voltage; 12
Named nets: 0
.tran 2
