dezsoba/Szakdolgozat/(commit log)

2016-11-10 End of 11.10.
    [Digital_ORDER.xlsx, Echo.xlsx, Farnell.xlsx, IO_szakdoga.xlsx, Supplies.xlsx, i2c pullup.xlsx]
2016-11-18 end of 11.18.
    [Analog_ORDER.xlsx, Digital_ORDER.xlsx, Echo.xlsx, Farnell.xlsx]
2016-11-20 Restructured 11.20.
    Restructured, added new parts: Active Loads in general, etc.
    [Analog_ORDER.xlsx]
2016-11-21 11.21 end of day
    [Analog_ORDER.xlsx, Echo.xlsx, Farnell.xlsx, RSonline.xlsx]
2016-11-22 Added X-RAY_DFNs
    [Analog_ORDER.xlsx]
2016-11-23 Added small part about DAC, shreg, and calibration VI
2016-11-29 100% working, added adapter voltage spike image, changed VI
2016-11-30 final work day
    [aram meres.xlsx]
2016-12-01 Maybe rdy
    [Spec.xlsx]
